Arksu96/DSA-PIR_RF_Sensor/README.md

View this project on [CADLAB.io](https://cadlab.io/project/26397). 

# DSA-PIR_RF_Sensor
