Arksu96/DSA-PIR_RF_Sensor/Firmware/PIR_RF_Sensor/README.md

v0.0.4
- LD2410 data checker
- Report and ACK receiving 
- UART Circular DMA
x LD2410 configuration data transmitting 
x LD2410 parser for received data 

v0.0.3
- PIR 
- RFM69 (transmitting)
- SPI
- LD2410 (Init)
