Arksu96/DSA-PIR_RF_Sensor/Hardware/STM32 PIR Sensor.kicad_pcb

## KiCad design Hardware/STM32 PIR Sensor.kicad_pcb (2023-04-01)

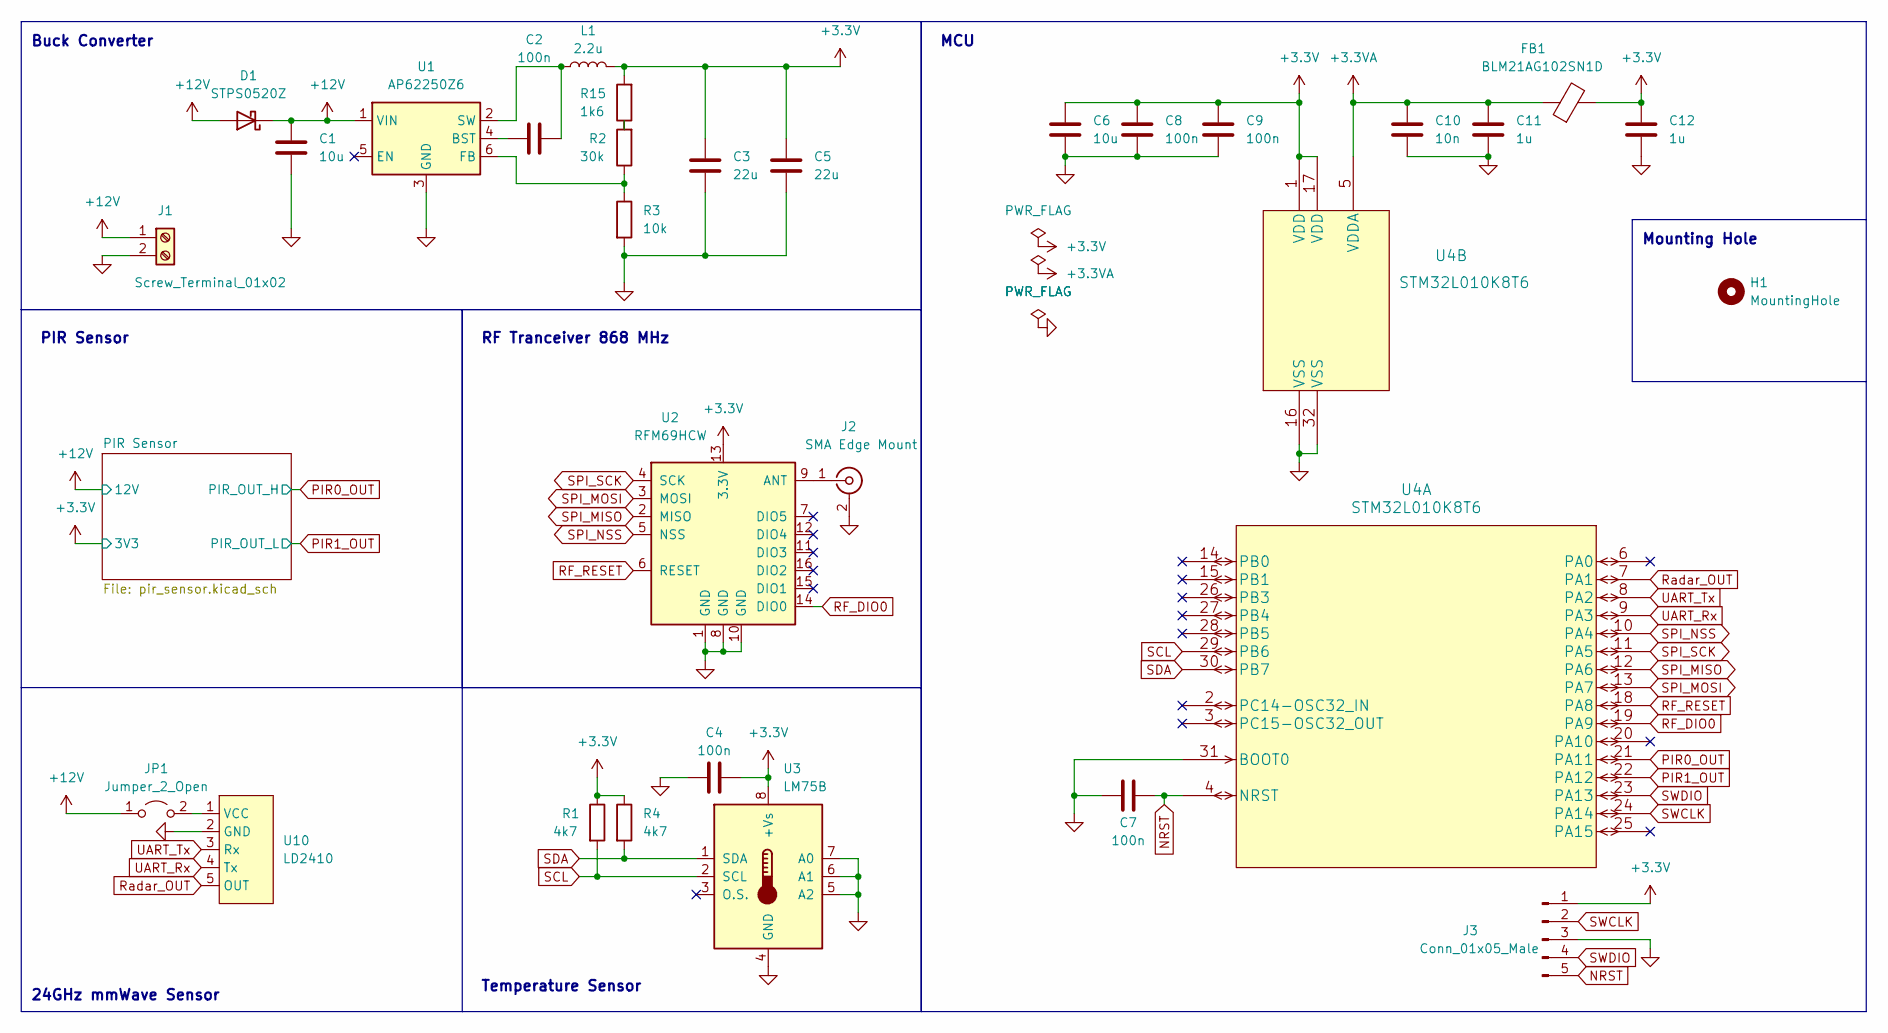
[picture p1: schematic STM32 PIR Sensor.kicad_sch]

Parts:
C1, C6: 10u; C_0603_1608Metric_Pad1.08x0.95mm_HandSolder
C2, C4, C7, C8, C9: 100n; C_0603_1608Metric_Pad1.08x0.95mm_HandSolder
C3, C5: 22u; C_0805_2012Metric_Pad1.18x1.45mm_HandSolder
C10: 10n; C_0603_1608Metric_Pad1.08x0.95mm_HandSolder
C11, C12: 1u; C_0603_1608Metric_Pad1.08x0.95mm_HandSolder
D1: STPS0520Z; D_SOD-123
FB1: BLM21AG102SN1D; L_0805_2012Metric_Pad1.05x1.20mm_HandSolder
H1: MountingHole; MountingHole_5mm
J1: Screw_Terminal_01x02; DG301R-5.0
J2: SMA Edge Mount; SMA_Amphenol_132289_EdgeMount
J3: Conn_01x05_Male; PinHeader_1x05_P2.54mm_Vertical
JP1: Jumper_2_Open; SolderJumper-2_P1.3mm_Open_TrianglePad1.0x1.5mm
L1: 2.2u; L_0805_2012Metric_Pad1.05x1.20mm_HandSolder
R1, R4: 4k7; R_0603_1608Metric_Pad0.98x0.95mm_HandSolder
R2: 30k; R_0603_1608Metric_Pad0.98x0.95mm_HandSolder
R3: 10k; R_0603_1608Metric_Pad0.98x0.95mm_HandSolder
R15: 1k6; R_0603_1608Metric_Pad0.98x0.95mm_HandSolder
U1: AP62250Z6; TSOT-23-6
U2: RFM69HCW; RFM69HCW-XXXS2
U3: LM75B; SO-8_5.3x6.2mm_P1.27mm
U4: STM32L010K8T6; LQFP-32_7x7mm_P0.8mm
U10: LD2410

Connections:
+3.3V: C3.1, C4.2, C5.1, C6.1, C8.1, C9.1, C12.1, FB1.2, J3.1, L1.2, R1.1, R4.1, R15.2, U2.13 (3.3V), U3.8 (+Vs), U4.1 (VDD), U4.17 (VDD); also elsewhere on the board
+3.3VA: C10.1, C11.1, FB1.1, U4.5 (VDDA)
+12V: C1.1, D1.1 (K), D1.2 (A), J1.1, JP1.1 (A), U1.1 (VIN); also elsewhere on the board
GND: C1.2, C3.2, C4.1, C5.2, C6.2, C7.1, C8.2, C9.2, C10.2, C11.2, C12.2, J1.2, J2.2 (Ext), J3.3, R3.2, U1.3 (GND), U2.1 (GND), U2.8 (GND), U2.10 (GND), U3.4 (GND), U3.5 (A2), U3.6 (A1), U3.7 (A0), U4.16 (VSS), U4.31 (BOOT0), U4.32 (VSS), U10.2 (GND); also elsewhere on the board
NRST: C7.2, J3.5, U4.4 (NRST)
unnamed: C2.1, U1.4 (BST)
unnamed: C2.2, L1.1, U1.2 (SW)
unnamed: J2.1 (In), U2.9 (ANT)
unnamed: JP1.2 (B), U10.1 (VCC)
unnamed: R2.1, R3.1, U1.6 (FB)
unnamed: R2.2, R15.1
PIR0_OUT: U4.21 (PA11); also elsewhere on the board
PIR1_OUT: U4.22 (PA12); also elsewhere on the board
RF_DIO0: U2.14 (DIO0), U4.19 (PA9)
RF_RESET: U2.6 (RESET), U4.18 (PA8)
Radar_OUT: U4.7 (PA1), U10.5 (OUT)
SCL: R1.2, U3.2 (SCL), U4.29 (PB6)
SDA: R4.2, U3.1 (SDA), U4.30 (PB7)
SPI_MISO: U2.2 (MISO), U4.12 (PA6)
SPI_MOSI: U2.3 (MOSI), U4.13 (PA7)
SPI_NSS: U2.5 (NSS), U4.10 (PA4)
SPI_SCK: U2.4 (SCK), U4.11 (PA5)
SWCLK: J3.2, U4.24 (PA14)
SWDIO: J3.4, U4.23 (PA13)
UART_Rx: U4.9 (PA3), U10.4 (Tx)
UART_Tx: U4.8 (PA2), U10.3 (Rx)

Notes on the sheet:
Mounting Hole
PIR Sensor
Temperature Sensor
MCU
Buck Converter
24GHz mmWave Sensor
RF Tranceiver 868 MHz

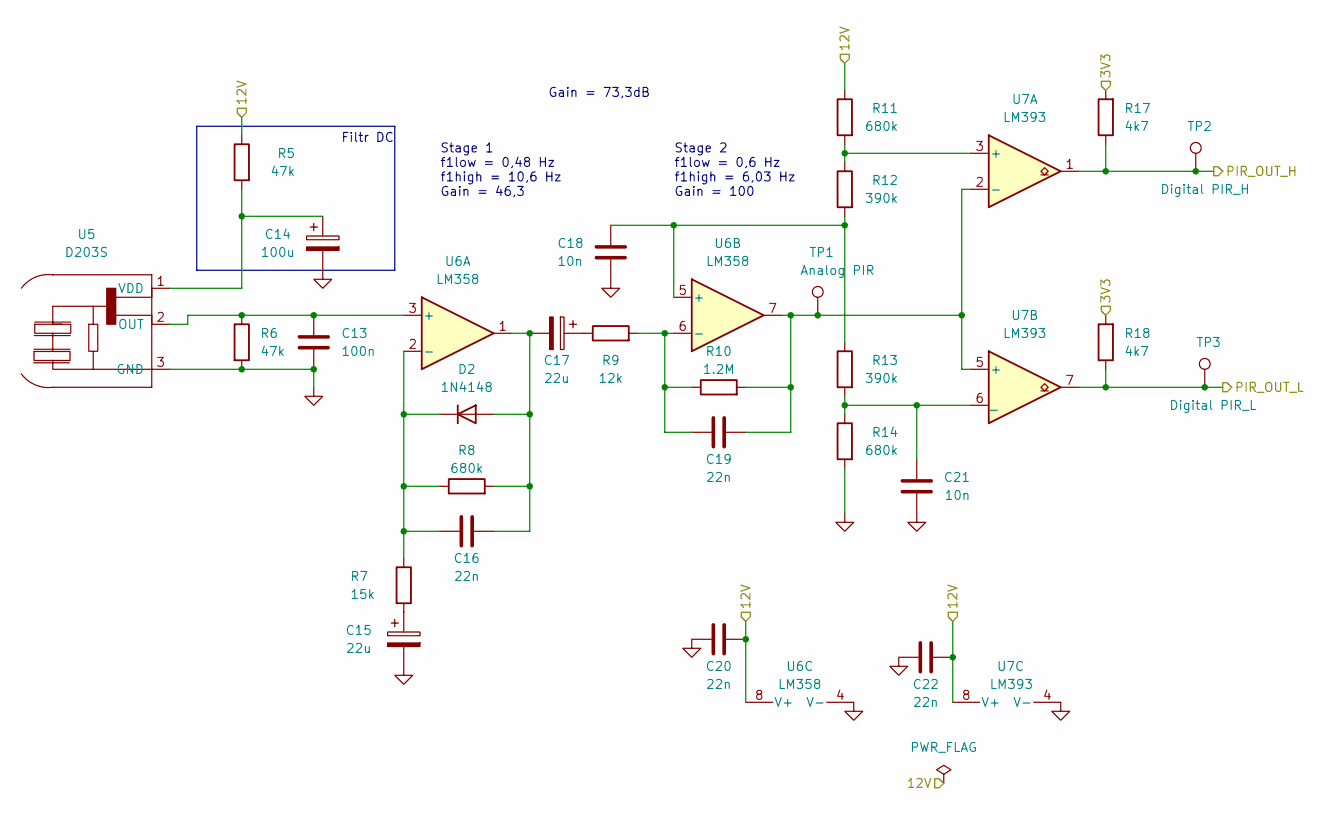
[picture p2: schematic pir_sensor.kicad_sch]

Parts:
C13: 100n; C_0603_1608Metric_Pad1.08x0.95mm_HandSolder
C14: 100u; CP_Elec_6.3x5.4
C15, C17: 22u; C_0805_2012Metric_Pad1.18x1.45mm_HandSolder
C16, C19, C20, C22: 22n; C_0603_1608Metric_Pad1.08x0.95mm_HandSolder
C18, C21: 10n; C_0603_1608Metric_Pad1.08x0.95mm_HandSolder
D2: 1N4148; D_MiniMELF
R5, R6: 47k; R_0603_1608Metric_Pad0.98x0.95mm_HandSolder
R7: 15k; R_0603_1608Metric_Pad0.98x0.95mm_HandSolder
R8, R11, R14: 680k; R_0603_1608Metric_Pad0.98x0.95mm_HandSolder
R9: 12k; R_0603_1608Metric_Pad0.98x0.95mm_HandSolder
R10: 1.2M; R_0603_1608Metric_Pad0.98x0.95mm_HandSolder
R12, R13: 390k; R_0603_1608Metric_Pad0.98x0.95mm_HandSolder
R17, R18: 4k7; R_0603_1608Metric_Pad0.98x0.95mm_HandSolder
TP1: Analog PIR; TestPoint_Pad_D1.0mm
TP2: Digital PIR_H; TestPoint_Pad_D1.0mm
TP3: Digital PIR_L; TestPoint_Pad_D1.0mm
U5: D203S; TO-5-3
U6: LM358; SO-8_5.3x6.2mm_P1.27mm
U7: LM393; SO-8_5.3x6.2mm_P1.27mm

Connections:
+3.3V: R17.2, R18.2; also elsewhere on the board
+12V: C20.2, C22.2, R5.1, R11.1, U6.8 (V+), U7.8 (V+); also elsewhere on the board
GND: C13.2, C14.2, C15.2, C18.2, C20.1, C21.2, C22.1, R6.2, R14.2, U5.3 (GND), U6.4 (V-), U7.4 (V-); also elsewhere on the board
unnamed: C13.1, R6.1, U5.2 (OUT), U6.3 (+)
unnamed: C14.1, R5.2, U5.1 (VDD)
unnamed: C15.1, R7.2
unnamed: C16.1, D2.1 (K), R7.1, R8.1, U6.2 (-)
unnamed: C16.2, C17.2, D2.2 (A), R8.2, U6.1
unnamed: C17.1, R9.1
unnamed: C18.1, R12.2, R13.1, U6.5 (+)
unnamed: C19.1, R9.2, R10.1, U6.6 (-)
unnamed: C19.2, R10.2, TP1.1, U6.7, U7.2 (-), U7.5 (+)
unnamed: C21.1, R13.2, R14.1, U7.6 (_)
unnamed: R11.2, R12.1, U7.3 (+)
PIR0_OUT: R17.1, TP2.1, U7.1; also elsewhere on the board
PIR1_OUT: R18.1, TP3.1, U7.7; also elsewhere on the board

Notes on the sheet:
Gain = 73,3dB
Filtr DC
Stage 2 f1low = 0,6 Hz f1high = 6,03 Hz Gain = 100
Stage 1 f1low = 0,48 Hz f1high = 10,6 Hz Gain = 46,3

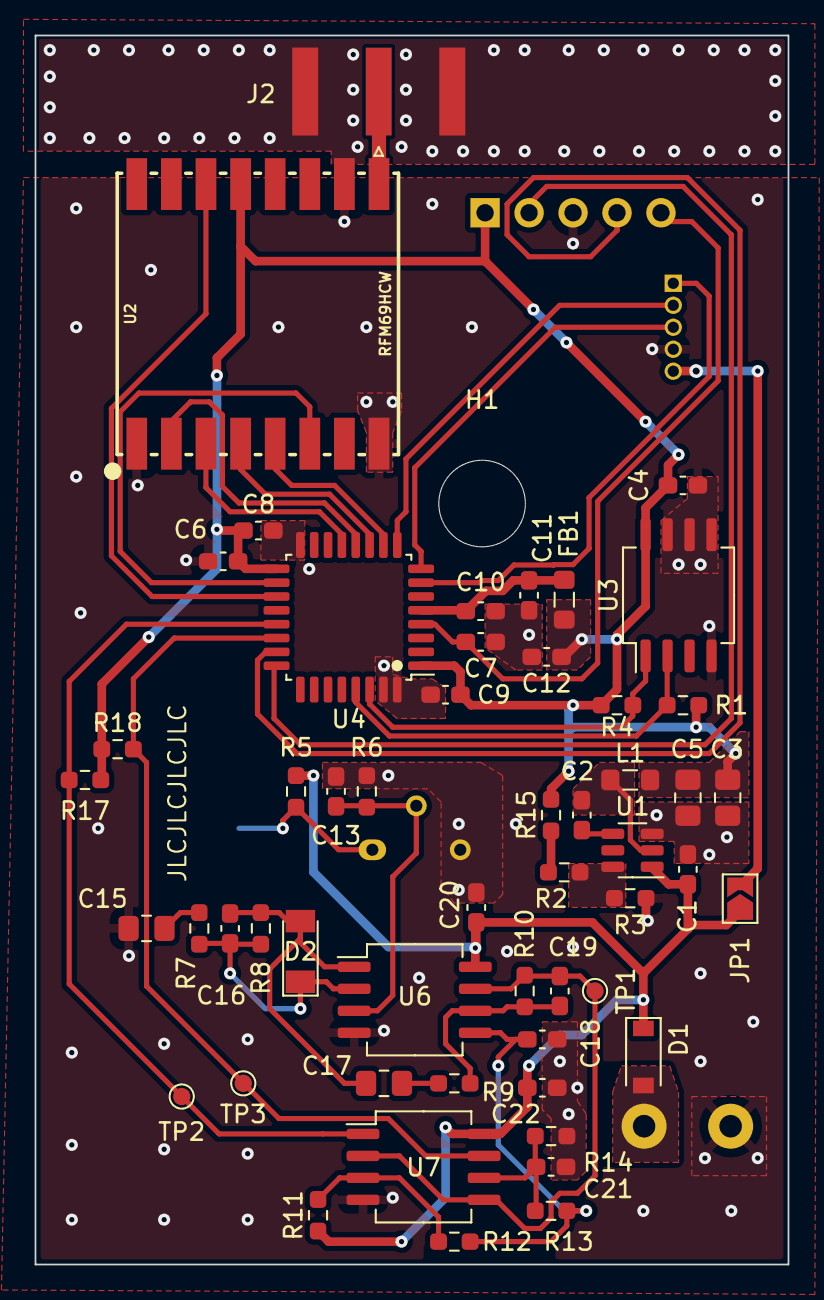
[picture p3: board STM32 PIR Sensor.kicad_pcb from above]

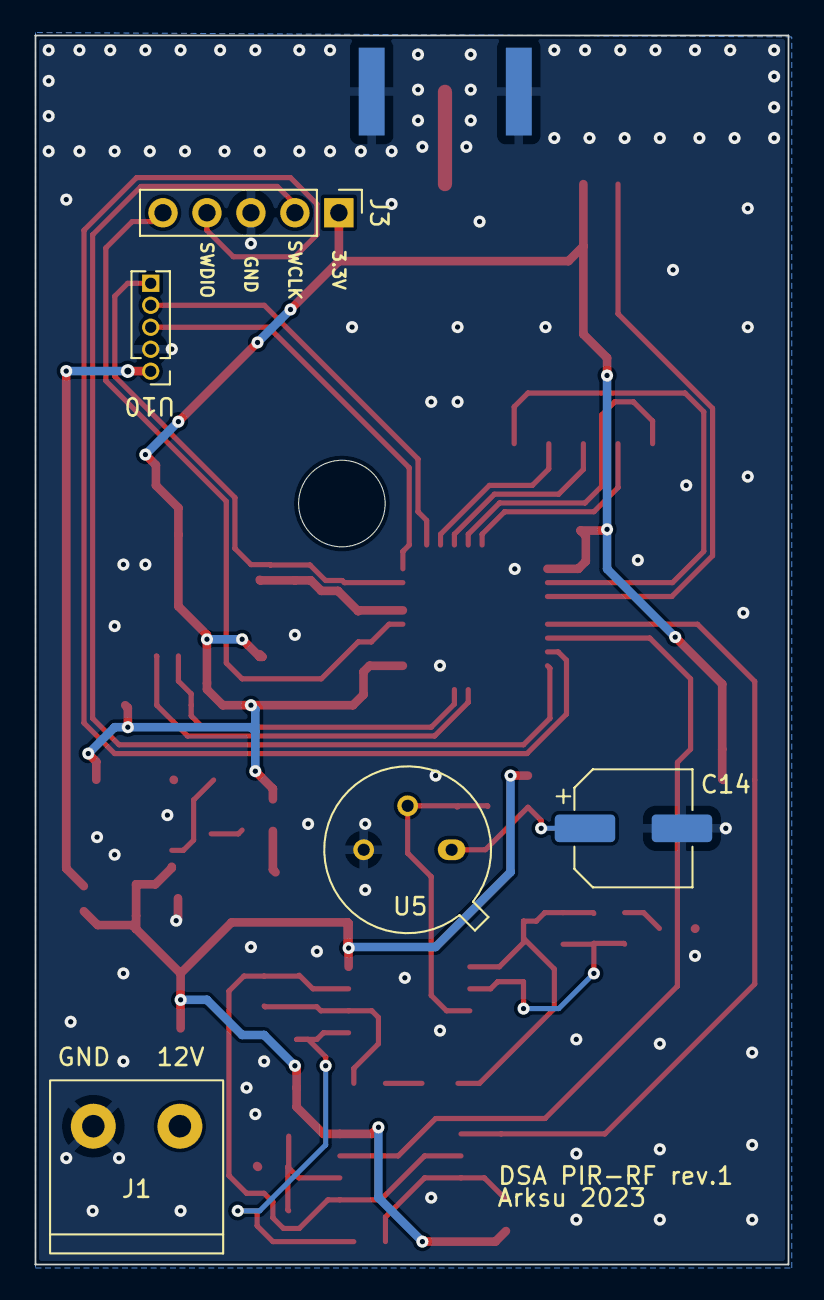
[picture p4: board STM32 PIR Sensor.kicad_pcb from below]

Board: 2 copper layers, 43.5 x 71.0 mm, 59 parts (5 on the bottom side), 37 nets.
