Arksu96/DSA-PIR_RF_Sensor/Firmware/PIR_RF_Sensor/Core/Src/main.c

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
/* Includes ------------------------------------------------------------------*/
#include "main.h"
#include "dma.h"
#include "i2c.h"
#include "spi.h"
#include "tim.h"
#include "usart.h"
#include "gpio.h"

/* USER CODE BEGIN Includes */
#include "RFM69.h"
#include "PIR.h"
#include "LD2410.h"
#include "ringbuffer.h"
/* USER CODE END Includes */

/* USER CODE BEGIN PD */
#define UARTLENGTH 64
/* USER CODE END PD */


/* USER CODE BEGIN PV */
//RFM69
uint8_t deviceType = 0;
uint8_t RFMinit = 0;
uint8_t RFMMessageOK = 0;
//PIR
PIR_Event PIR[MAX_NUM_OF_EVENTS];
PIR_Occurance PIR_instance;
//UART
uint8_t ReceiveBuffer[UARTLENGTH];
ring_buffer_t ring_buffer;
char buf_arr[UARTLENGTH];
char tmp;
//LD2410
struct LD2410_Detection detection;

/* USER CODE END PV */

void SystemClock_Config(void);
static void MX_NVIC_Init(void);
/**
  * @brief  The application entry point.
  * @retval int
  */
int main(void)
{
  /* MCU Configuration--------------------------------------------------------*/

  /* Reset of all peripherals, Initializes the Flash interface and the Systick. */
  HAL_Init();

  /* Configure the system clock */
  SystemClock_Config();

  /* Initialize all configured peripherals */
  MX_GPIO_Init();
  MX_DMA_Init();
  MX_I2C1_Init();
  MX_SPI1_Init();
  MX_TIM2_Init();
  MX_USART2_UART_Init();

  /* Initialize interrupts */
  MX_NVIC_Init();
  /* USER CODE BEGIN 2 */
  //RFM69
  SPIInit(&hspi1);
  if(RFM69_initialize(RF69_868MHZ, 2, 1)){
	  RFMinit = 1;
	  RFM69_initMsg();
  }
  deviceType = RFM69_readReg(0x10);
  //PIR
  //PIR_init();
  //UART
  ring_buffer_init(&ring_buffer, buf_arr, sizeof(buf_arr));
  HAL_UART_Receive_DMA(&huart2, ReceiveBuffer, UARTLENGTH);

  /* USER CODE END 2 */

  /* Infinite loop */
  /* USER CODE BEGIN WHILE */
  while (1)
  {
	  setConfigMode(1);
	  /*//Check if timeout on PIR
	  if(PIR_SensivityTimeout(&PIR_instance) || PIR_counterLimit(&PIR_instance)){
		  //Send info to ESP
		  if(PIR_sendRF(&PIR_instance, PIR)){
			  PIR_reset(&PIR_instance);
		  } else {
			  RFM69_send(RF_MASTER_ID, "Sent failed", sizeof(char)*11, false);
		  }
	  }*/
	  //getFirmwareVersion();
//	  if(ring_buffer_is_full(&ring_buffer)){
//		  while(ring_buffer_dequeue(&ring_buffer, &tmp) > 0);
//	  }

    /* USER CODE END WHILE */

    /* USER CODE BEGIN 3 */
  }
  /* USER CODE END 3 */
}

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
/* USER CODE BEGIN 4 */
void HAL_GPIO_EXTI_Callback(uint16_t GPIO_Pin)
{
	if(GPIO_Pin == RF_Payload_Pin && checkInterruptStatus())
	{
		RFM69_ISRRx();
	}
	if(GPIO_Pin == PIR_H_Pin)
	{
		if(HAL_GPIO_ReadPin(PIR_H_GPIO_Port, PIR_H_Pin) == GPIO_PIN_SET){
			PIR_DetectionCallback(PIR_H_Pin, PIR_RISING, &PIR[PIR_instance.PIR_numOfEvents], &PIR_instance);
		} else {
			PIR_DetectionCallback(PIR_H_Pin, PIR_FALLING, &PIR[PIR_instance.PIR_numOfEvents], &PIR_instance);
		}
	}
	if(GPIO_Pin == PIR_L_Pin)
	{
		if(HAL_GPIO_ReadPin(PIR_L_GPIO_Port, PIR_L_Pin) == GPIO_PIN_SET){
			PIR_DetectionCallback(PIR_L_Pin, PIR_RISING, &PIR[PIR_instance.PIR_numOfEvents], &PIR_instance);
		} else {
			PIR_DetectionCallback(PIR_L_Pin, PIR_FALLING, &PIR[PIR_instance.PIR_numOfEvents], &PIR_instance);
		}
	}
}

void HAL_UART_TxCpltCallback(UART_HandleTypeDef *huart)
{
	// Check if UART2 triggered the Callback
	if(huart->Instance == USART2)
	{
		HAL_UART_Receive_DMA(&huart2, ReceiveBuffer, UARTLENGTH);
	}
}

void HAL_UART_RxCpltCallback(UART_HandleTypeDef *huart)
{
	// Check if UART2 trigger the Callback
	if(huart->Instance == USART2)
	{
		ring_buffer_queue_arr(&ring_buffer, (char*)ReceiveBuffer, UARTLENGTH);
		readline((unsigned char *)buf_arr, &detection);
	}
}

void HAL_UART_ErrorCallback(UART_HandleTypeDef *huart)
{
	// Check if UART2 trigger the Callback
	if(huart->Instance == USART2)
	{
		//HAL_UARTEx_ReceiveToIdle_DMA(&huart2, ReceiveBuffer, 10);
	}
}


/* USER CODE END 4 */
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
