Arksu96/DSA-PIR_RF_Sensor/Firmware/PIR_RF_Sensor/PIR_RF_Sensor.ioc

Mcu.UserName=STM32L010K8Tx
PA1.GPIO_Label=Radar_OUT
PA1.Signal=GPIO_Output
PA11.GPIO_Label=PIR_H
PA11.Signal=GPXTI11
PA12.GPIO_Label=PIR_L
PA12.Signal=GPXTI12
PA13.Signal=SYS_SWDIO
PA14.Signal=SYS_SWCLK
PA2.Signal=USART2_TX
PA3.Signal=USART2_RX
PA4.GPIO_Label=SPI1_NSS
PA4.Signal=GPIO_Output
PA5.Signal=SPI1_SCK
PA6.Signal=SPI1_MISO
PA7.Signal=SPI1_MOSI
PA8.GPIO_Label=RF_Reset
PA8.Signal=GPIO_Output
PA9.GPIO_Label=RF_Payload
PA9.Signal=GPXTI9
PB6.Signal=I2C1_SCL
PB7.Signal=I2C1_SDA
