Arksu96/DSA-PIR_RF_Sensor/Firmware/PIR_RF_Sensor/Core/Src/RFM69.c

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
// Licence can be viewed at                               
// http://www.gnu.org/licenses/gpl-3.0.txt
//
// Please maintain this license information along with authorship
// and copyright notices in any redistribution of this code
// **********************************************************************************
#include "RFM69.h"
#include "RFM69registers.h"
#include "main.h"

static volatile uint8_t data[RF69_MAX_DATA_LEN]; // recv/xmit buf, including header & crc bytes
static volatile uint8_t datalen;
static volatile uint8_t senderID;
static volatile uint8_t targetID;                // should match _address
static volatile uint8_t payloadLen;
static volatile uint8_t ACK_Requested;
static volatile uint8_t ACK_RECEIVED;           // should be polled immediately after sending a packet with ACK request
static volatile uint8_t _mode = RF69_MODE_STANDBY;
static volatile int16_t rssi;                   // most accurate RSSI during reception (closest to the reception)

static uint8_t _address;
static uint8_t _powerLevel = 31;
bool _promiscuousMode = false;

// internal
static void RFM69_sendFrame(uint8_t toAddress, const void* buffer, uint8_t size, bool requestACK, bool sendACK);

//EXTI
bool RF_IRQ = true;

//Timer
uint32_t timerValue = 0;
uint32_t tickStart = 0;

//SPI
SPI_HandleTypeDef *RFM_hspi;

void SPIInit(SPI_HandleTypeDef *spi)
{
	RFM_hspi = spi;
}
void RFM69_reset()
{
	HAL_GPIO_WritePin(RF_Reset_GPIO_Port, RF_Reset_Pin, GPIO_PIN_SET);
	HAL_Delay(100);
	HAL_GPIO_WritePin(RF_Reset_GPIO_Port, RF_Reset_Pin, GPIO_PIN_RESET);
	HAL_Delay(100);
}

bool RFM69_initialize(uint8_t freqBand, uint8_t nodeID, uint16_t networkID)
{
  const uint8_t CONFIG[][2] =
  {
    /* 0x01 */ { REG_OPMODE, RF_OPMODE_SEQUENCER_ON | RF_OPMODE_LISTEN_OFF | RF_OPMODE_STANDBY },
    /* 0x02 */ { REG_DATAMODUL, RF_DATAMODUL_DATAMODE_PACKET | RF_DATAMODUL_MODULATIONTYPE_FSK | RF_DATAMODUL_MODULATIONSHAPING_00 }, // no shaping
    /* 0x03 */ { REG_BITRATEMSB, RF_BITRATEMSB_55555}, // default: 4.8 KBPS
    /* 0x04 */ { REG_BITRATELSB, RF_BITRATELSB_55555},
    /* 0x05 */ { REG_FDEVMSB, RF_FDEVMSB_50000}, // default: 5KHz, (FDEV + BitRate / 2 <= 500KHz)
    /* 0x06 */ { REG_FDEVLSB, RF_FDEVLSB_50000},

    /* 0x07 */ { REG_FRFMSB, (uint8_t) (freqBand==RF69_315MHZ ? RF_FRFMSB_315 : (freqBand==RF69_433MHZ ? RF_FRFMSB_433 : (freqBand==RF69_868MHZ ? RF_FRFMSB_868 : RF_FRFMSB_915))) },
    /* 0x08 */ { REG_FRFMID, (uint8_t) (freqBand==RF69_315MHZ ? RF_FRFMID_315 : (freqBand==RF69_433MHZ ? RF_FRFMID_433 : (freqBand==RF69_868MHZ ? RF_FRFMID_868 : RF_FRFMID_915))) },
    /* 0x09 */ { REG_FRFLSB, (uint8_t) (freqBand==RF69_315MHZ ? RF_FRFLSB_315 : (freqBand==RF69_433MHZ ? RF_FRFLSB_433 : (freqBand==RF69_868MHZ ? RF_FRFLSB_868 : RF_FRFLSB_915))) },

    // looks like PA1 and PA2 are not implemented on RFM69W, hence the max output power is 13dBm
    // +17dBm and +20dBm are possible on RFM69HW
    // +13dBm formula: Pout = -18 + OutputPower (with PA0 or PA1**)
    // +17dBm formula: Pout = -14 + OutputPower (with PA1 and PA2)**
    // +20dBm formula: Pout = -11 + OutputPower (with PA1 and PA2)** and high power PA settings (section 3.3.7 in datasheet)
    ///* 0x11 */ { REG_PALEVEL, RF_PALEVEL_PA0_ON | RF_PALEVEL_PA1_OFF | RF_PALEVEL_PA2_OFF | RF_PALEVEL_OUTPUTPOWER_11111},
    ///* 0x13 */ { REG_OCP, RF_OCP_ON | RF_OCP_TRIM_95 }, // over current protection (default is 95mA)

    // RXBW defaults are { REG_RXBW, RF_RXBW_DCCFREQ_010 | RF_RXBW_MANT_24 | RF_RXBW_EXP_5} (RxBw: 10.4KHz)
    /* 0x19 */ { REG_RXBW, RF_RXBW_DCCFREQ_010 | RF_RXBW_MANT_16 | RF_RXBW_EXP_2 }, // (BitRate < 2 * RxBw)
    //for BR-19200: /* 0x19 */ { REG_RXBW, RF_RXBW_DCCFREQ_010 | RF_RXBW_MANT_24 | RF_RXBW_EXP_3 },
    /* 0x25 */ { REG_DIOMAPPING1, RF_DIOMAPPING1_DIO0_01 }, // DIO0 is the only IRQ we're using
    /* 0x26 */ { REG_DIOMAPPING2, RF_DIOMAPPING2_CLKOUT_OFF }, // DIO5 ClkOut disable for power saving
    /* 0x28 */ { REG_IRQFLAGS2, RF_IRQFLAGS2_FIFOOVERRUN }, // writing to this bit ensures that the FIFO & status flags are reset
    /* 0x29 */ { REG_RSSITHRESH, 220 }, // must be set to dBm = (-Sensitivity / 2), default is 0xE4 = 228 so -114dBm
    ///* 0x2D */ { REG_PREAMBLELSB, RF_PREAMBLESIZE_LSB_VALUE } // default 3 preamble bytes 0xAAAAAA
    /* 0x2E */ { REG_SYNCCONFIG, RF_SYNC_ON | RF_SYNC_FIFOFILL_AUTO | RF_SYNC_SIZE_2 | RF_SYNC_TOL_0 },
    /* 0x2F */ { REG_SYNCVALUE1, (uint8_t)(networkID & 0x00FF) },  // NETWORK ID lower 8 bits
    /* 0x30 */ { REG_SYNCVALUE2, (uint8_t)(networkID >> 8) },      // NETWORK ID higher 8 bits
    /* 0x37 */ { REG_PACKETCONFIG1, RF_PACKET1_FORMAT_VARIABLE | RF_PACKET1_DCFREE_OFF | RF_PACKET1_CRC_ON | RF_PACKET1_CRCAUTOCLEAR_ON | RF_PACKET1_ADRSFILTERING_OFF },
    /* 0x38 */ { REG_PAYLOADLENGTH, 66 }, // in variable length mode: the max frame size, not used in TX
    ///* 0x39 */ { REG_NODEADRS, nodeID }, // turned off because we're not using address filtering
    /* 0x3C */ { REG_FIFOTHRESH, RF_FIFOTHRESH_TXSTART_FIFONOTEMPTY | RF_FIFOTHRESH_VALUE }, // TX on FIFO not empty
    /* 0x3D */ { REG_PACKETCONFIG2, RF_PACKET2_RXRESTARTDELAY_2BITS | RF_PACKET2_AUTORXRESTART_ON | RF_PACKET2_AES_OFF }, // RXRESTARTDELAY must match transmitter PA ramp-down time (bitrate dependent)
    //for BR-19200: /* 0x3D */ { REG_PACKETCONFIG2, RF_PACKET2_RXRESTARTDELAY_NONE | RF_PACKET2_AUTORXRESTART_ON | RF_PACKET2_AES_OFF }, // RXRESTARTDELAY must match transmitter PA ramp-down time (bitrate dependent)
    /* 0x6F */ { REG_TESTDAGC, RF_DAGC_IMPROVED_LOWBETA0 }, // run DAGC continuously in RX mode for Fading Margin Improvement, recommended default for AfcLowBetaOn=0
    {255, 0}
  };
  
  RFM69_reset();
  RFM69_SetCSPin(HIGH);
  /*Timeout_SetTimeout1(50);
  do
  {
    RFM69_writeReg(REG_SYNCVALUE1, 0xAA); 
  }
  while (RFM69_readReg(REG_SYNCVALUE1) != 0xaa && !Timeout_IsTimeout1());
  
  Timeout_SetTimeout1(50);
  do
  {
    RFM69_writeReg(REG_SYNCVALUE1, 0x55); 
  }
  while (RFM69_readReg(REG_SYNCVALUE1) != 0x55 && !Timeout_IsTimeout1());
*/
  for (uint8_t i = 0; CONFIG[i][0] != 255; i++)
  {
    RFM69_writeReg(CONFIG[i][0], CONFIG[i][1]);
  }

  // Encryption is persistent between resets and can trip you up during debugging.
  // Disable it during initialization so we always start from a known state.
  RFM69_encrypt(0);

  RFM69_setHighPower(ISRFM69HW); // called regardless if it's a RFM69W or RFM69HW
  RFM69_setMode(RF69_MODE_STANDBY);
  Timeout_SetTimeout1(300);
  while (((RFM69_readReg(REG_IRQFLAGS1) & RF_IRQFLAGS1_MODEREADY) == 0x00) && !Timeout_IsTimeout1()); // wait for ModeReady
  if (Timeout_IsTimeout1())
  {
    return false;
  }

  _address = nodeID;
  return true;
}

// return the frequency (in Hz)
uint32_t RFM69_getFrequency()
{
  return RF69_FSTEP * (((uint32_t) RFM69_readReg(REG_FRFMSB) << 16) + ((uint16_t) RFM69_readReg(REG_FRFMID) << 8) + RFM69_readReg(REG_FRFLSB));
}

// set the frequency (in Hz)
void RFM69_setFrequency(uint32_t freqHz)
{
  uint8_t oldMode = _mode;
  if (oldMode == RF69_MODE_TX) {
    RFM69_setMode(RF69_MODE_RX);
  }
  freqHz /= RF69_FSTEP; // divide down by FSTEP to get FRF
  RFM69_writeReg(REG_FRFMSB, freqHz >> 16);
  RFM69_writeReg(REG_FRFMID, freqHz >> 8);
  RFM69_writeReg(REG_FRFLSB, freqHz);
  if (oldMode == RF69_MODE_RX) {
    RFM69_setMode(RF69_MODE_SYNTH);
  }
  RFM69_setMode(oldMode);
}

void RFM69_setMode(uint8_t newMode)
{
  if (newMode == _mode)
    return;

  switch (newMode) {
    case RF69_MODE_TX:
      RFM69_writeReg(REG_OPMODE, (RFM69_readReg(REG_OPMODE) & 0xE3) | RF_OPMODE_TRANSMITTER);
      if (ISRFM69HW) RFM69_setHighPowerRegs(true);
      break;
    case RF69_MODE_RX:
      RFM69_writeReg(REG_OPMODE, (RFM69_readReg(REG_OPMODE) & 0xE3) | RF_OPMODE_RECEIVER);
      if (ISRFM69HW) RFM69_setHighPowerRegs(false);
      break;
    case RF69_MODE_SYNTH:
      RFM69_writeReg(REG_OPMODE, (RFM69_readReg(REG_OPMODE) & 0xE3) | RF_OPMODE_SYNTHESIZER);
      break;
    case RF69_MODE_STANDBY:
      RFM69_writeReg(REG_OPMODE, (RFM69_readReg(REG_OPMODE) & 0xE3) | RF_OPMODE_STANDBY);
      break;
    case RF69_MODE_SLEEP:
      RFM69_writeReg(REG_OPMODE, (RFM69_readReg(REG_OPMODE) & 0xE3) | RF_OPMODE_SLEEP);
      break;
    default:
      return;
  }

  // we are using packet mode, so this check is not really needed
  // but waiting for mode ready is necessary when going from sleep because the FIFO may not be immediately available from previous mode
  while (_mode == RF69_MODE_SLEEP && (RFM69_readReg(REG_IRQFLAGS1) & RF_IRQFLAGS1_MODEREADY) == 0x00); // wait for ModeReady

  _mode = newMode;
}

//put transceiver in sleep mode to save battery - to wake or resume receiving just call RFM69_receiveDone()
void RFM69_sleep() {
  RFM69_setMode(RF69_MODE_SLEEP);
}

//set this node's address
void RFM69_setAddress(uint8_t addr)
{
  _address = addr;
  RFM69_writeReg(REG_NODEADRS, _address);
}

//set this node's network id
void RFM69_setNetwork(uint16_t networkID)
{
  RFM69_writeReg(REG_SYNCVALUE1, (uint8_t)(networkID & 0x00FF));
  RFM69_writeReg(REG_SYNCVALUE2, (uint8_t)(networkID >> 8));
}

// set *transmit/TX* output power: 0=min, 31=max
// this results in a "weaker" transmitted signal, and directly results in a lower RSSI at the receiver
// the power configurations are explained in the SX1231H datasheet (Table 10 on p21; RegPaLevel p66): http://www.semtech.com/images/datasheet/sx1231h.pdf
// valid powerLevel parameter values are 0-31 and result in a directly proportional effect on the output/transmission power
// this function implements 2 modes as follows:
//       - for RFM69W the range is from 0-31 [-18dBm to 13dBm] (PA0 only on RFIO pin)
//       - for RFM69HW the range is from 0-31 [5dBm to 20dBm]  (PA1 & PA2 on PA_BOOST pin & high Power PA settings - see section 3.3.7 in datasheet, p22)
void RFM69_setPowerLevel(uint8_t powerLevel)
{
  _powerLevel = (powerLevel > 31 ? 31 : powerLevel);
  if (ISRFM69HW)
  {
    _powerLevel /= 2;
  }
  RFM69_writeReg(REG_PALEVEL, (RFM69_readReg(REG_PALEVEL) & 0xE0) | _powerLevel);
}

bool RFM69_canSend()
{
  if (_mode == RF69_MODE_RX && payloadLen == 0 && RFM69_readRSSI(false) < CSMA_LIMIT) // if signal stronger than -100dBm is detected assume channel activity
  {
    RFM69_setMode(RF69_MODE_STANDBY);
    return true;
  }
  return false;
}

void RFM69_send(uint8_t toAddress, const void* buffer, uint8_t bufferSize, bool requestACK)
{
  RFM69_writeReg(REG_PACKETCONFIG2, (RFM69_readReg(REG_PACKETCONFIG2) & 0xFB) | RF_PACKET2_RXRESTART); // avoid RX deadlocks
  //uint32_t now = millis();
  while (!RFM69_canSend() /*&& millis() - now < RF69_CSMA_LIMIT_MS*/) RFM69_receiveDone();
  RFM69_sendFrame(toAddress, buffer, bufferSize, requestACK, false);
}

// to increase the chance of getting a packet across, call this function instead of send
// and it handles all the ACK requesting/retrying for you :)
// The only twist is that you have to manually listen to ACK requests on the other side and send back the ACKs
// The reason for the semi-automaton is that the lib is interrupt driven and
// requires user action to read the received data and decide what to do with it
// replies usually take only 5..8ms at 50kbps@915MHz
bool RFM69_sendWithRetry(uint8_t toAddress, const void* buffer, uint8_t bufferSize, uint8_t retries, uint8_t retryWaitTime) 
{
  for (uint8_t i = 0; i <= retries; i++)
  {
    RFM69_send(toAddress, buffer, bufferSize, true);
    Timeout_SetTimeout1(retryWaitTime);
    while (!Timeout_IsTimeout1()){
      if (RFM69_ACKReceived(toAddress)){
        return true;
      }
    }
  }
  return false;
}

// should be polled immediately after sending a packet with ACK request
bool RFM69_ACKReceived(uint8_t fromNodeID) 
{
  if (RFM69_receiveDone())
    return (senderID == fromNodeID || fromNodeID == RF69_BROADCAST_ADDR) && ACK_RECEIVED;
  return false;
}

// check whether an ACK was requested in the last received packet (non-broadcasted packet)
bool RFM69_ACKRequested() 
{
  return ACK_Requested && (targetID != RF69_BROADCAST_ADDR);
}

// should be called immediately after reception in case sender wants ACK
void RFM69_sendACK(const void* buffer, uint8_t bufferSize) 
{
  ACK_Requested = 0;   // TWS added to make sure we don't end up in a timing race and infinite loop sending Acks
  uint8_t sender = senderID;
  int16_t l_rssi = rssi; // save payload received RSSI value
  RFM69_writeReg(REG_PACKETCONFIG2, (RFM69_readReg(REG_PACKETCONFIG2) & 0xFB) | RF_PACKET2_RXRESTART); // avoid RX deadlocks
  Timeout_SetTimeout1(RF69_CSMA_LIMIT_MS);
  while (!RFM69_canSend() && !Timeout_IsTimeout1())
  {
    RFM69_receiveDone();
  }
  senderID = sender;    // TWS: Restore senderID after it gets wiped out by RFM69_receiveDone()
  RFM69_sendFrame(sender, buffer, bufferSize, false, true);
  rssi = l_rssi; // restore payload RSSI
}

// internal function
static void RFM69_sendFrame(uint8_t toAddress, const void* buffer, uint8_t bufferSize, bool requestACK, bool sendACK)
{
  RFM69_setMode(RF69_MODE_STANDBY); // turn off receiver to prevent reception while filling fifo
  while ((RFM69_readReg(REG_IRQFLAGS1) & RF_IRQFLAGS1_MODEREADY) == 0x00); // wait for ModeReady
  RFM69_writeReg(REG_DIOMAPPING1, RF_DIOMAPPING1_DIO0_00); // DIO0 is "Packet Sent"
  if (bufferSize > RF69_MAX_DATA_LEN) bufferSize = RF69_MAX_DATA_LEN;

  // control byte
  uint8_t CTLbyte = 0x00;
  if (sendACK)
    CTLbyte = RFM69_CTL_SENDACK;
  else if (requestACK)
    CTLbyte = RFM69_CTL_REQACK;

  // write to FIFO
  RFM69_select();
  SPI_transfer8(REG_FIFO | 0x80);
  SPI_transfer8(bufferSize + 3);
  SPI_transfer8(toAddress);
  SPI_transfer8(_address);
  SPI_transfer8(CTLbyte);

  for (uint8_t i = 0; i < bufferSize; i++)
    SPI_transfer8(((uint8_t*) buffer)[i]);
  RFM69_unselect();

  // no need to wait for transmit mode to be ready since its handled by the radio
  RFM69_setMode(RF69_MODE_TX);
  Timeout_SetTimeout1(RF69_TX_LIMIT_MS);
  while (RFM69_ReadDIO0Pin() == 0 && !Timeout_IsTimeout1()); // wait for DIO0 to turn HIGH signalling transmission finish
  //while (RFM69_readReg(REG_IRQFLAGS2) & RF_IRQFLAGS2_PACKETSENT == 0x00); // wait for ModeReady
  RFM69_setMode(RF69_MODE_STANDBY);
}

// internal function - interrupt gets called when a packet is received
void RFM69_interruptHandler() {
  
  if (_mode == RF69_MODE_RX && (RFM69_readReg(REG_IRQFLAGS2) & RF_IRQFLAGS2_PAYLOADREADY))
  {
    uint8_t CTLbyte;
    //rssi = RFM69_readRSSI();
    RFM69_setMode(RF69_MODE_STANDBY);
    RFM69_select();
    SPI_transfer8(REG_FIFO & 0x7F);
    payloadLen = SPI_transfer8(0);
    payloadLen = payloadLen > 66 ? 66 : payloadLen; // precaution
    targetID = SPI_transfer8(0);
    if(!(_promiscuousMode || targetID == _address || targetID == RF69_BROADCAST_ADDR) // match this node's address, or broadcast address or anything in promiscuous mode
       || payloadLen < 3) // address situation could receive packets that are malformed and don't fit this libraries extra fields
    {
      payloadLen = 0;
      RFM69_unselect();
      RFM69_receiveBegin();
      return;
    }

    datalen = payloadLen - 3;
    senderID = SPI_transfer8(0);
    CTLbyte = SPI_transfer8(0);

    ACK_RECEIVED = CTLbyte & RFM69_CTL_SENDACK; // extract ACK-received flag
    ACK_Requested = CTLbyte & RFM69_CTL_REQACK; // extract ACK-requested flag
    
    //interruptHook(CTLbyte);     // TWS: hook to derived class interrupt function

    for (uint8_t i = 0; i < datalen; i++)
    {
      data[i] = SPI_transfer8(0);
    }
    if (datalen < RF69_MAX_DATA_LEN) data[datalen] = 0; // add null at end of string
    RFM69_unselect();
    RFM69_setMode(RF69_MODE_RX);
  }
  rssi = RFM69_readRSSI(false);
  //Parser
}

// internal function
//void RFM69::isr0() { selfPointer->interruptHandler(); }

// internal function
void RFM69_receiveBegin() 
{
  datalen = 0;
  senderID = 0;
  targetID = 0;
  payloadLen = 0;
  ACK_Requested = 0;
  ACK_RECEIVED = 0;
  rssi = 0;
  if (RFM69_readReg(REG_IRQFLAGS2) & RF_IRQFLAGS2_PAYLOADREADY)
    RFM69_writeReg(REG_PACKETCONFIG2, (RFM69_readReg(REG_PACKETCONFIG2) & 0xFB) | RF_PACKET2_RXRESTART); // avoid RX deadlocks
  RFM69_writeReg(REG_DIOMAPPING1, RF_DIOMAPPING1_DIO0_01); // set DIO0 to "PAYLOADREADY" in receive mode
  RFM69_setMode(RF69_MODE_RX);
}

// checks if a packet was received and/or puts transceiver in receive (ie RX or listen) mode
bool RFM69_receiveDone() 
{
//ATOMIC_BLOCK(ATOMIC_FORCEON)
  noInterrupts(); // re-enabled in RFM69_unselect() via setMode() or via RFM69_receiveBegin()
  if (_mode == RF69_MODE_RX && payloadLen > 0)
  {
    RFM69_setMode(RF69_MODE_STANDBY); // enables interrupts
    return true;
  }
  else if (_mode == RF69_MODE_RX) // already in RX no payload yet
  {
    interrupts(); // explicitly re-enable interrupts
    return false;
  }
  RFM69_receiveBegin();
  return false;
}

// To enable encryption: radio.encrypt("ABCDEFGHIJKLMNOP");
// To disable encryption: radio.encrypt(null) or radio.encrypt(0)
// KEY HAS TO BE 16 bytes !!!
void RFM69_encrypt(const char* key) 
{
  RFM69_setMode(RF69_MODE_STANDBY);
  if (key != 0)
  {
    RFM69_select();
    SPI_transfer8(REG_AESKEY1 | 0x80);
    for (uint8_t i = 0; i < 16; i++)
      SPI_transfer8(key[i]);
    RFM69_unselect();
  }
  RFM69_writeReg(REG_PACKETCONFIG2, (RFM69_readReg(REG_PACKETCONFIG2) & 0xFE) | (key ? 1 : 0));
}

// get the received signal strength indicator (RSSI)
int16_t RFM69_readRSSI(bool forceTrigger) 
{
  int16_t rssi = 0;
  if (forceTrigger)
  {
    // RSSI trigger not needed if DAGC is in continuous mode
    RFM69_writeReg(REG_RSSICONFIG, RF_RSSI_START);
    while ((RFM69_readReg(REG_RSSICONFIG) & RF_RSSI_DONE) == 0x00); // wait for RSSI_Ready
  }
  rssi = -RFM69_readReg(REG_RSSIVALUE);
  rssi >>= 1;
  return rssi;
}

// true  = disable filtering to capture all frames on network
// false = enable node/broadcast filtering to capture only frames sent to this/broadcast address
void RFM69_promiscuous(bool onOff) 
{
  _promiscuousMode = onOff;
  //RFM69_writeReg(REG_PACKETCONFIG1, (RFM69_readReg(REG_PACKETCONFIG1) & 0xF9) | (onOff ? RF_PACKET1_ADRSFILTERING_OFF : RF_PACKET1_ADRSFILTERING_NODEBROADCAST));
}

// for RFM69HW only: you must call RFM69_setHighPower(true) after initialize() or else transmission won't work
void RFM69_setHighPower(bool onOff) {
  RFM69_writeReg(REG_OCP, ISRFM69HW ? RF_OCP_OFF : RF_OCP_ON);
  if (ISRFM69HW) // turning ON
    RFM69_writeReg(REG_PALEVEL, (RFM69_readReg(REG_PALEVEL) & 0x1F) | RF_PALEVEL_PA1_ON | RF_PALEVEL_PA2_ON); // enable P1 & P2 amplifier stages
  else
    RFM69_writeReg(REG_PALEVEL, RF_PALEVEL_PA0_ON | RF_PALEVEL_PA1_OFF | RF_PALEVEL_PA2_OFF | _powerLevel); // enable P0 only
}

// internal function
void RFM69_setHighPowerRegs(bool onOff) 
{
  RFM69_writeReg(REG_TESTPA1, onOff ? 0x5D : 0x55);
  RFM69_writeReg(REG_TESTPA2, onOff ? 0x7C : 0x70);
}

uint8_t RFM69_readTemperature(uint8_t calFactor) // returns centigrade
{
  RFM69_setMode(RF69_MODE_STANDBY);
  RFM69_writeReg(REG_TEMP1, RF_TEMP1_MEAS_START);
  while ((RFM69_readReg(REG_TEMP1) & RF_TEMP1_MEAS_RUNNING));
  return ~RFM69_readReg(REG_TEMP2) + COURSE_TEMP_COEF + calFactor; // 'complement' corrects the slope, rising temp = rising val
} // COURSE_TEMP_COEF puts reading in the ballpark, user can add additional correction

void RFM69_rcCalibration()
{
  RFM69_writeReg(REG_OSC1, RF_OSC1_RCCAL_START);
  while ((RFM69_readReg(REG_OSC1) & RF_OSC1_RCCAL_DONE) == 0x00);
}

uint8_t RFM69_readReg(uint8_t addr)
{
  uint8_t regval;
  RFM69_select();
  SPI_transfer8(addr & 0x7F);
  regval = SPI_transfer8(0);
  RFM69_unselect();
  return regval;
}

void RFM69_writeReg(uint8_t addr, uint8_t value)
{
  RFM69_select();
  SPI_transfer8(addr | 0x80);
  SPI_transfer8(value);
  RFM69_unselect();
}

// select the RFM69 transceiver (save SPI settings, set CS low)
void RFM69_select() 
{
  noInterrupts();
  RFM69_SetCSPin(LOW);
}

// unselect the RFM69 transceiver (set CS high, restore SPI settings)
void RFM69_unselect() 
{
  RFM69_SetCSPin(HIGH);
  interrupts();
}

//EXTI
void noInterrupts()
{
	RF_IRQ = false;
}
void interrupts()
{
	RF_IRQ = true;
}
bool checkInterruptStatus()
{
	return RF_IRQ;
}

void RFM69_SetCSPin(bool CS_State)
{
	if(CS_State){
		HAL_GPIO_WritePin(SPI1_NSS_GPIO_Port, SPI1_NSS_Pin, GPIO_PIN_SET);
	} else {
		HAL_GPIO_WritePin(SPI1_NSS_GPIO_Port, SPI1_NSS_Pin, GPIO_PIN_RESET);
	}

}
bool RFM69_ReadDIO0Pin(void)
{
	return HAL_GPIO_ReadPin(RF_Payload_GPIO_Port, RF_Payload_Pin);
}
uint8_t SPI_transfer8(uint8_t byte)
{
	uint8_t readData;
	HAL_SPI_TransmitReceive(RFM_hspi, &byte, &readData, sizeof(byte), 1000);
	return readData;
}

bool Timeout_IsTimeout1(void)
{
	if((HAL_GetTick() - tickStart) >= timerValue){
		tickStart = HAL_GetTick();
		return true;
	}
	return false;
}
void Timeout_SetTimeout1(uint32_t Value)
{
	timerValue = Value;
	tickStart = HAL_GetTick();
}

void RFM69_ISRRx(void)
{
	noInterrupts();
	RFM69_interruptHandler();
	if(RFM69_ACKRequested()){
		RFM69_sendACK("OK", sizeof(char)*2);
	}
	interrupts();
	//Can add some error handling
}

void RFM69_initMsg(void)
{
	//RFM69 init correctly
	RFM69_sendWithRetry(RF_MASTER_ID, "RFi=1",
									sizeof(char)*5,
									RF_NUM_OF_RETRIES, RF_TX_TIMEOUT);
}
