Arksu96/DSA-PIR_RF_Sensor/(commit log)

2023-01-17 v0.1 Schematic
    [STM32 PIR Sensor.kicad_sch]
2023-01-22 v0.2 BOM
    [STM32 PIR Sensor.kicad_sch, pir_sensor.kicad_sch]
2023-04-01 v1.0 with issues
    [STM32 PIR Sensor-B_Cu.gbr, STM32 PIR Sensor-B_Mask.gbr, STM32 PIR Sensor-B_Paste.gbr, STM32 PIR Sensor-B_Silkscreen.gbr, STM32 PIR Sensor-Edge_Cuts.gbr, STM32 PIR Sensor-F_Cu.gbr, STM32 PIR Sensor-F_Mask.gbr, STM32 PIR Sensor-F_Paste.gbr]
2023-08-01 v0.0.3(1) PIR&RFM69
    [PIR_RF_Sensor Debug.cfg, pir_sensor.kicad_sch]
2023-08-14 v0.0.4(1) LD2410 crash - suspended
    [main.c]
