Arksu96/DSA-PIR_RF_Sensor/(notices)

Notices in the files:
Firmware/PIR_RF_Sensor/Core/Inc/main.h:
Copyright (c) 2023 STMicroelectronics.
All rights reserved.
This software is licensed under terms that can be found in the LICENSE file
Firmware/PIR_RF_Sensor/Core/Src/RFM69.c:
Copyright Felix Rusu (2014), felix@lowpowerlab.com
Public License as published by the Free Software
Public License along with this program.
